rockola/SpareRoom/SpareRoom_FullSchematic.pdf

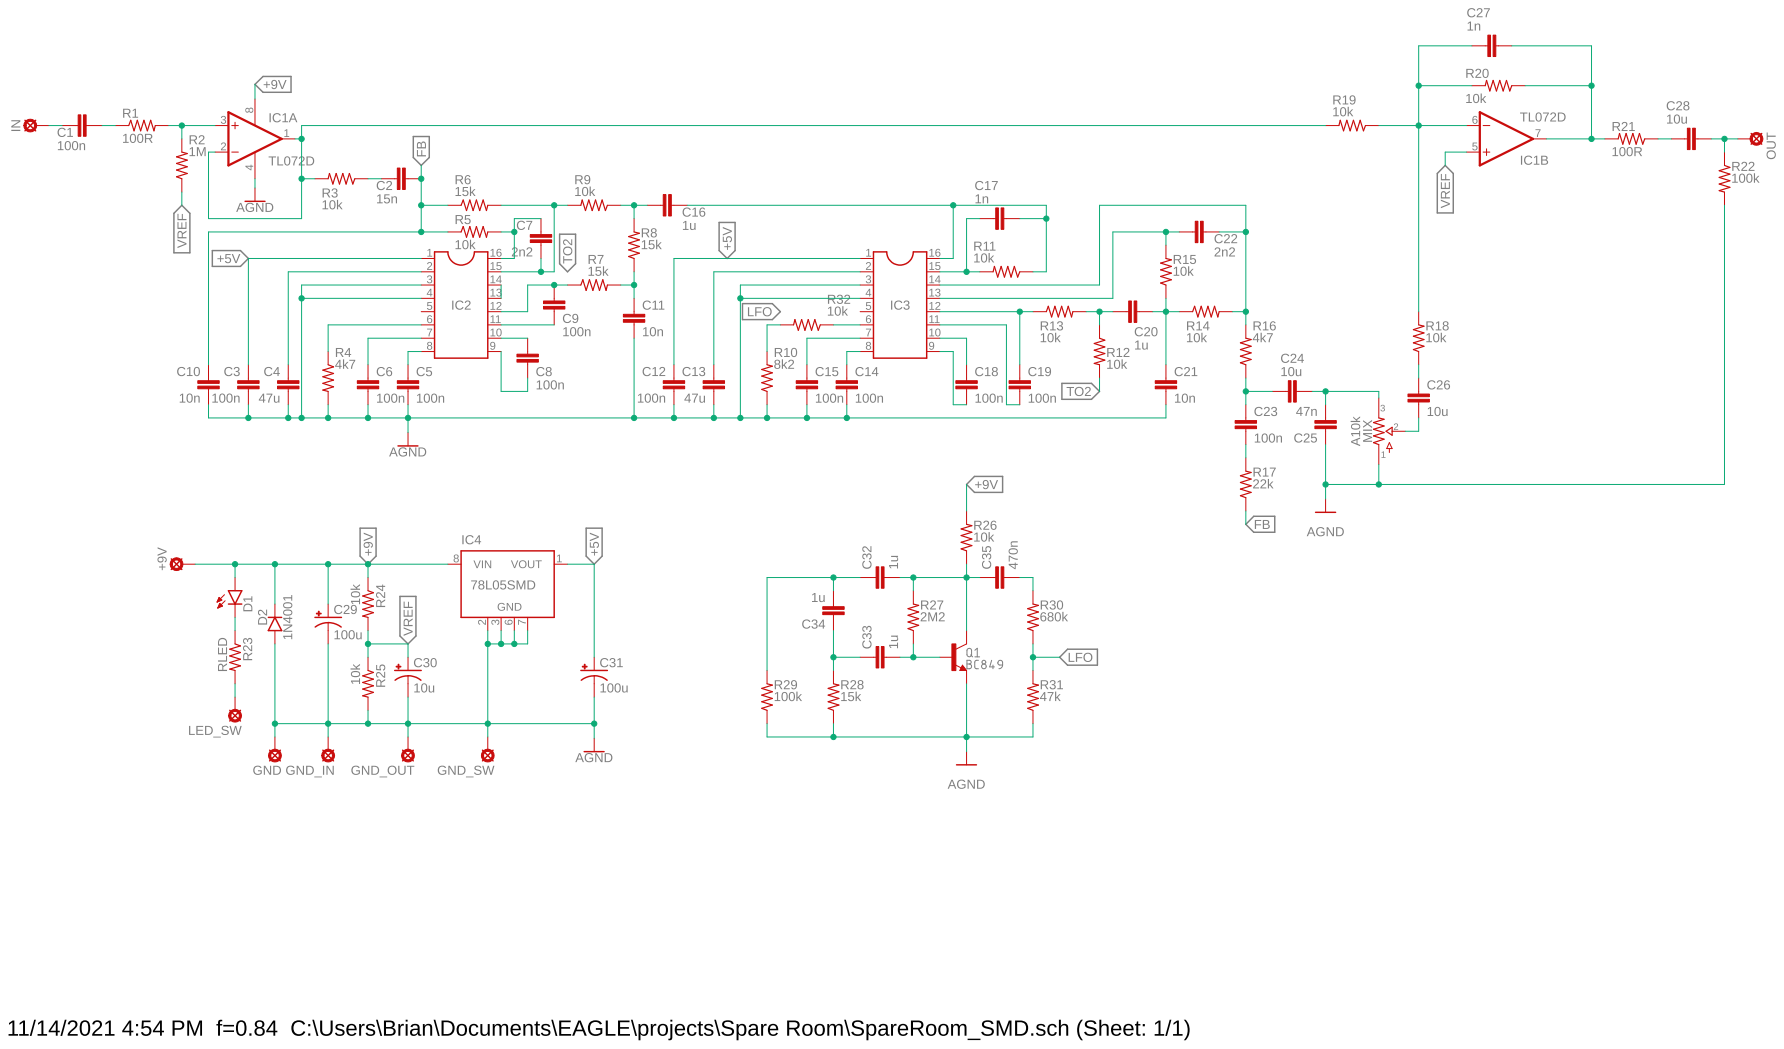
[picture p1: page 1]
